Nikitarc/AASun/AASun_External_Loader/changelog.txt

For the last release of AdAstra-RTK visit AdAstra-Soft . com

AASun_External_Loader is an external loader for STM32CubeProgrammer
It is configured for development and debug.
Can be compiled as standard version (with G071xx.ld) for test and debug
or as external loader with extLoader.ld

The project is configured for a G071CB custom board

--------------------------------------------------------
23/01		Project external loader AASun_W25Q64 for AASun

23/05/24	V1.0

23/09/30	V1.1	Use HSI as clock source (was HSE)

--------------------------------------------------------
