Nikitarc/AASun/DipTrace/AASun_1.0/AASun_PCB_V1.0.pdf

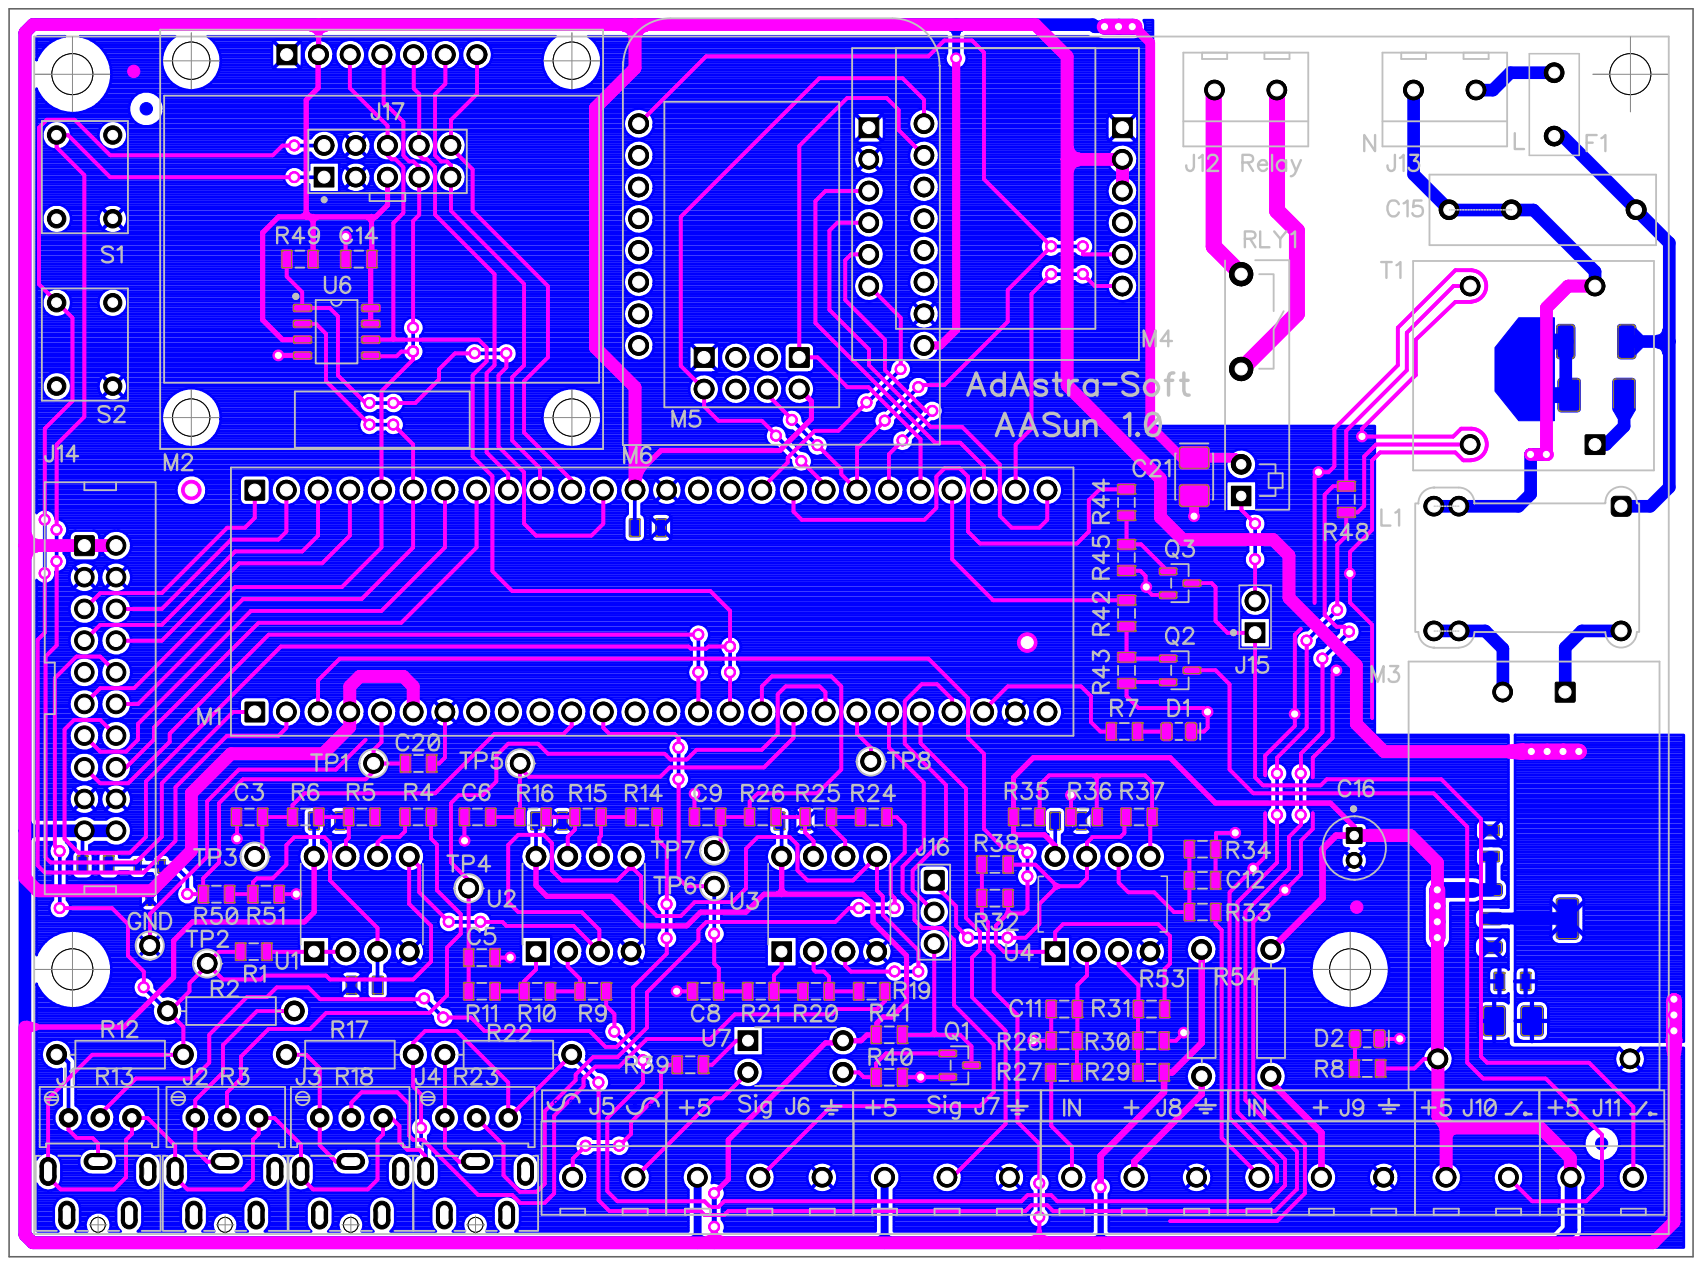
[picture p51: page 1]
