Nikitarc/AASun/DipTrace/AASun_1.0/AASun_Sch_V1.0.pdf

# R30 33k R31 220k R³² ⁴.7k R³³ ³.3k R³⁴ ¹⁰k

R530

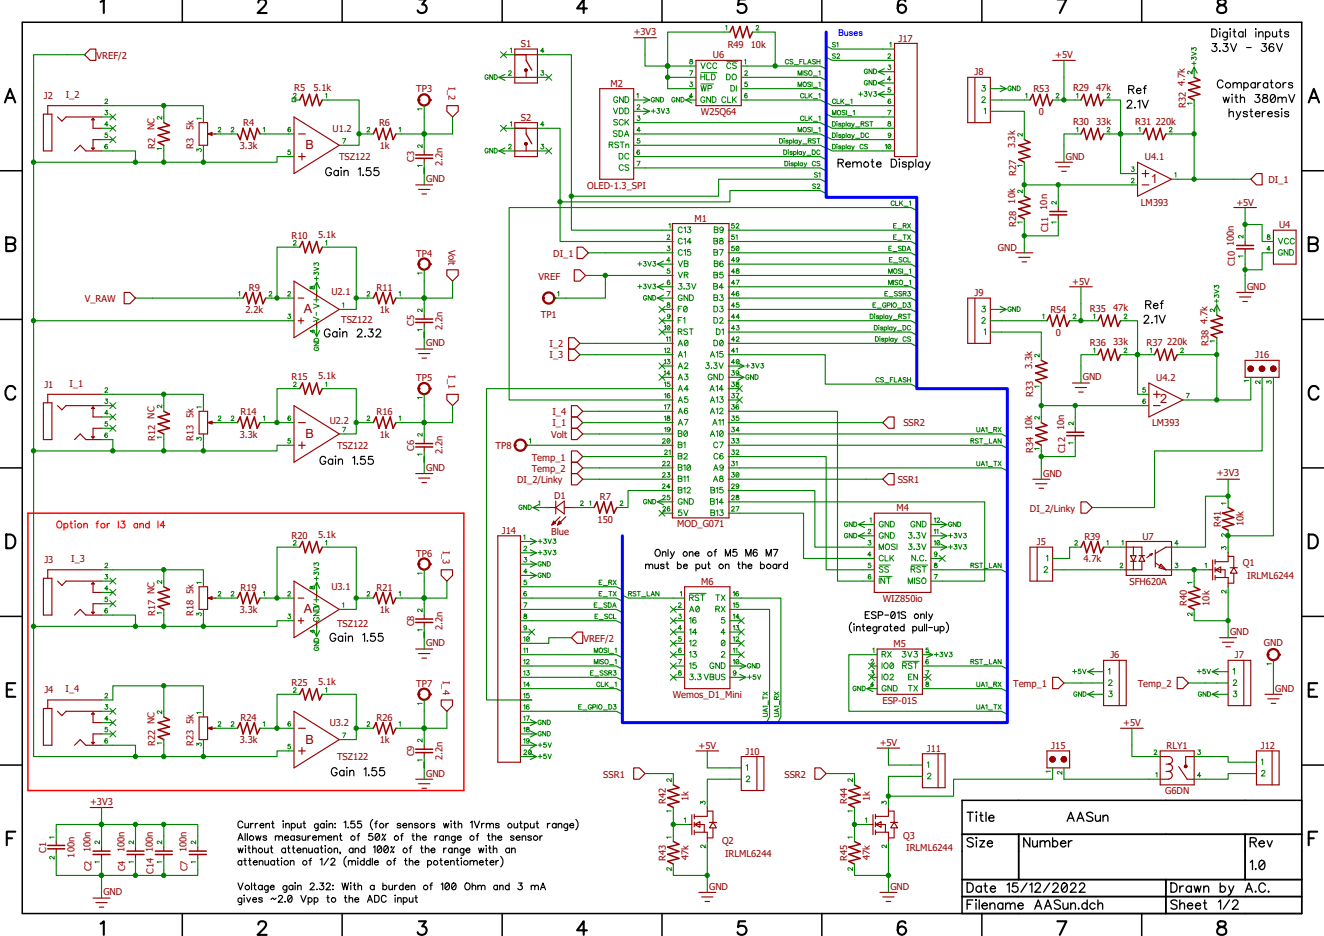
[picture p52: page 1]

A

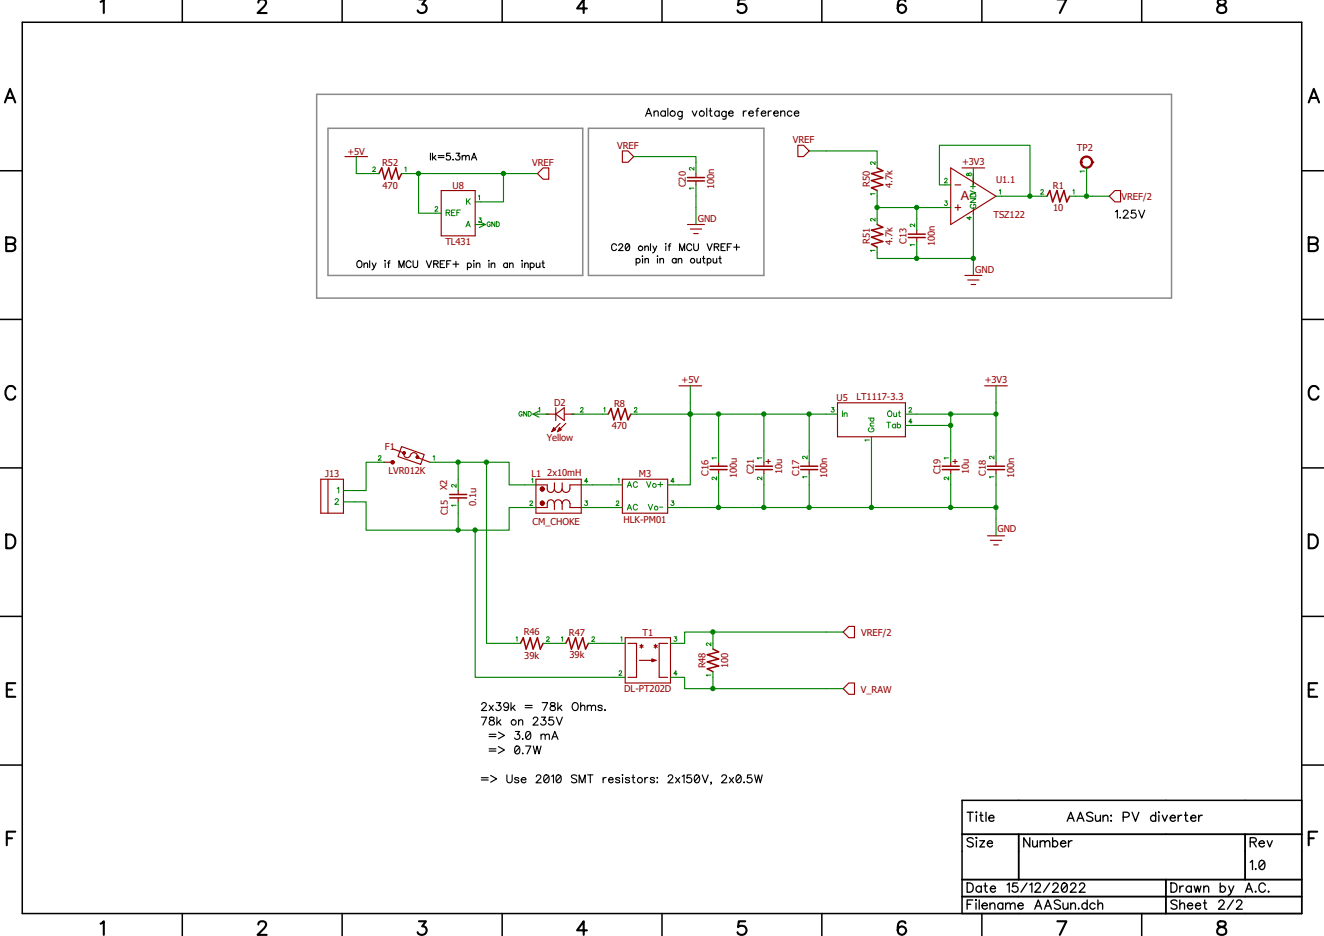
[picture p53: page 2]
