Nikitarc/AASun/DipTrace/AASun_Extension_1.1/AASun_Extension_PCB_V1.1.pdf

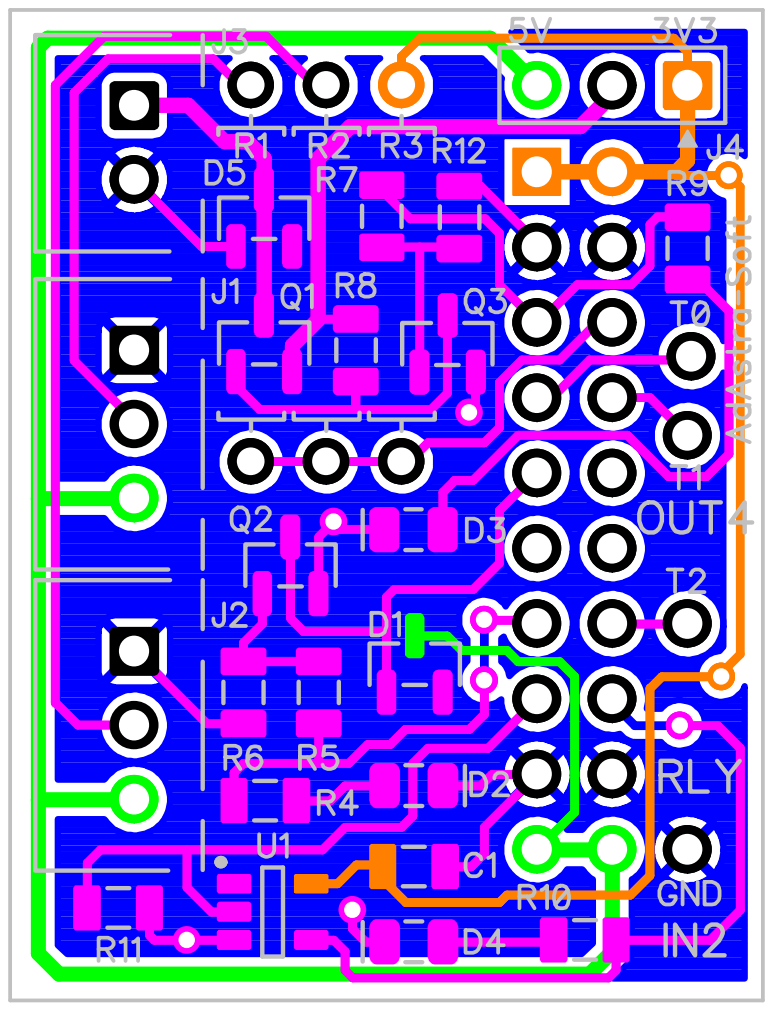
[picture p54: page 1]
