Nikitarc/AASun/DipTrace/AASun_Extension_1.1/AASun_Extension_Sch_V1.1.pdf

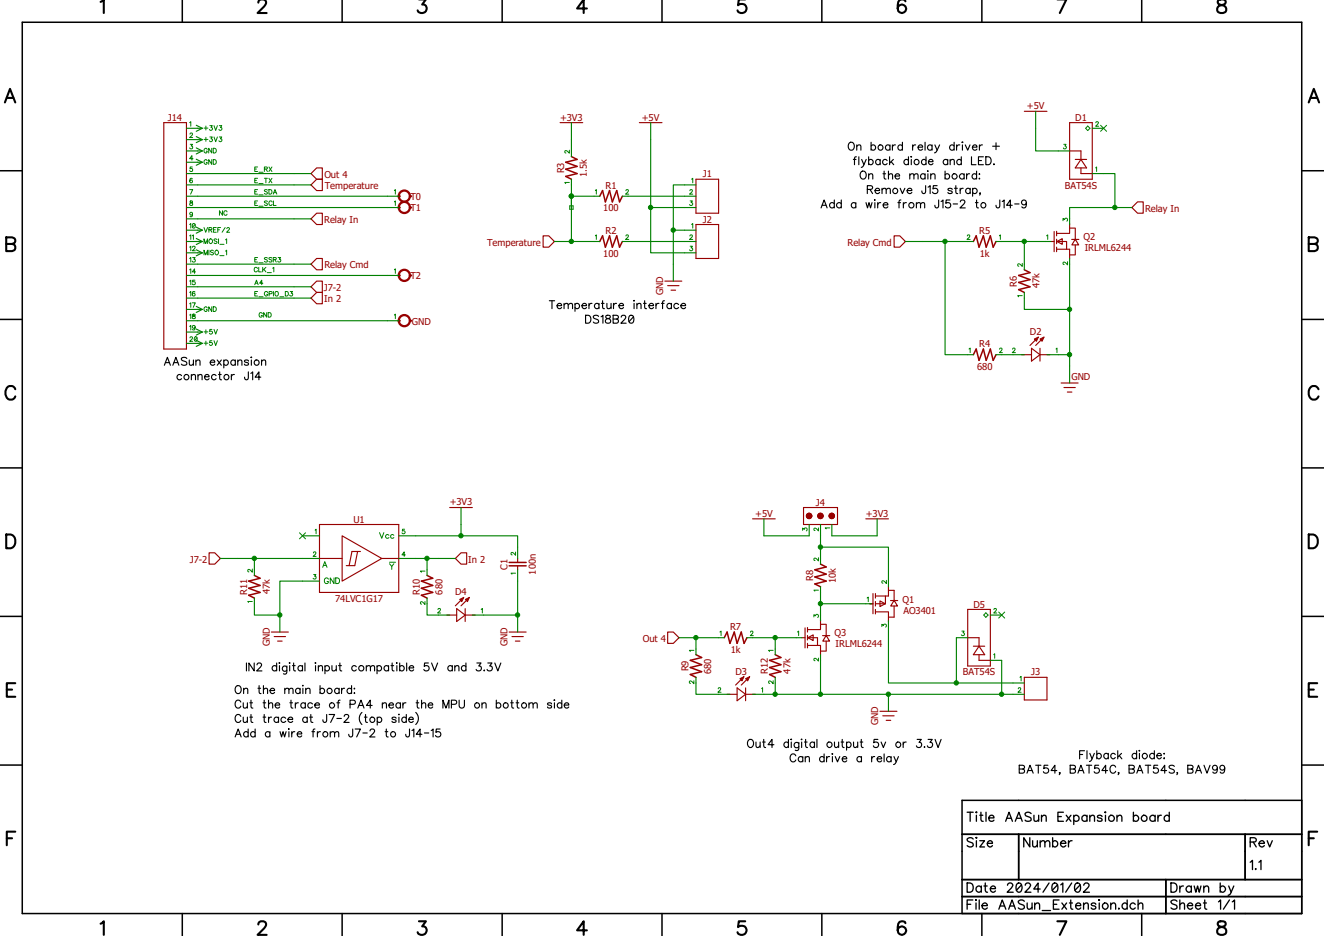
[picture p55: page 1]
