Nikitarc/AASun/(list of files, drawings)

Other design files:
DipTrace/AASun_1.0/AASun.dch
DipTrace/AASun_1.0/AASun.dip
DipTrace/AASun_1.0/AASunPanel.dip
DipTrace/AASun_Extension_1.1/AASun_Extension.dch
DipTrace/AASun_Extension_1.1/AASun_Extension.dip
