Nikitarc/AASun/AASun/AA/aakernel.c

/*
----------------------------------------------------------------------
	
	AdAstra - Real Time Kernel

	Alain Chebrou

	aakernel.c	Kernel base routines

	When		Who	What
	25/11/13	ac	Creation
	16/05/20	ac	V 1.8	Changed C++ static initialization
							Lightweight critical section added in aaTaskSwitch_()
	01/06/20	ac	V 1.9	Allow AA_MUTEX_MAX, AA_SEM_MAX, AA_TIMER_MAX, AA_QUEUE_MAX, AA_BUFPOOL_MAX to be 0
	12/06/21	ac	V 1.10	Remove simple mutex in aasema.c
							No more logMess task. The messages are displayed by the idle task.
	09/06/22	ac	V 1.11	TLSF: Fail to align to 0x04 or 0x0C in tlsfInit()
	17/04/24	ac	V 1.12	add aaIoResumeWaitingTask()

----------------------------------------------------------------------
*/
/*
----------------------------------------------------------------------
	Copyright (c) 2013-2023 Alain Chebrou - AdAstra-Soft . com
	All rights reserved.

	This file is part of the AdAstra Real Time Kernel distribution.

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
	- Redistributions of source code must retain the above copyright
	  notice, this list of conditions and the following disclaimer.

	- Redistributions in binary form must reproduce the above copyright
	  notice, this list of conditions and the following disclaimer in the
	  documentation and/or other materials provided with the distribution.

	- Neither the name of the copyright holder nor the
	  names of its contributors may be used to endorse or promote products
	  derived from this software without specific prior written permission.

	THIS SOFTWARE IS PROVIDED BY THE COPYRIGHT HOLDERS AND CONTRIBUTORS ``AS IS''
	AND ANY EXPRESS OR IMPLIED WARRANTIES, INCLUDING, BUT NOT LIMITED TO, THE IMPLIED
	WARRANTIES OF MERCHANTABILITY AND FITNESS FOR A PARTICULAR PURPOSE ARE
	DISCLAIMED. IN NO EVENT SHALL THE REGENTS AND CONTRIBUTORS BE LIABLE FOR ANY
	DIRECT, INDIRECT, INCIDENTAL, SPECIAL, EXEMPLARY, OR CONSEQUENTIAL DAMAGES
	(INCLUDING, BUT NOT LIMITED TO, PROCUREMENT OF SUBSTITUTE GOODS OR SERVICES;
	LOSS OF USE, DATA, OR PROFITS; OR BUSINESS INTERRUPTION) HOWEVER CAUSED AND
	ON ANY THEORY OF LIABILITY, WHETHER IN CONTRACT, STRICT LIABILITY, OR TORT
	(INCLUDING NEGLIGENCE OR OTHERWISE) ARISING IN ANY WAY OUT OF THE USE OF THIS
	SOFTWARE, EVEN IF ADVISED OF THE POSSIBILITY OF SUCH DAMAGE.
----------------------------------------------------------------------
*/

#define	AA_KERNEL_MAIN
#include	"aa.h"
#include	"aakernel.h"
#include	"aalogmes.h"
#include	"aatimer.h"

//--------------------------------------------------------------------------------
//	Return RTK version, with 2 numbers: Version - Release, eg 0x00010002 for 1.2

#define	AA_VERSION	((1u << 16u) | 11u)

uint32_t	aaVersion	(void)
{
	return AA_VERSION ;
}

//--------------------------------------------------------------------------------
// Task selector accelerator bitmap.
// In aaPrioGroup: 1 bit per priority level. Bit value is 1 when the corresponding ready list is not empty.
// Word 0 bit 0 is priority 0, word 1 bit 0 is priority bspPRIO_SIZE, etc.

#if (AA_PRIO_COUNT  > (BSP_PRIO_SIZE * BSP_PRIO_SIZE))
	#error AA_PRIO_COUNT should be lower than (BSP_PRIO_SIZE * BSP_PRIO_SIZE)
#endif

// Count of group words in aaPrioGroup. Can optimize code if value is 1 or 2
#define	aaPRIO_GROUP_COUNT	((AA_PRIO_COUNT+BSP_PRIO_SIZE-1) / BSP_PRIO_SIZE)

STATIC	bspPrio_t	aaPrioGroup [aaPRIO_GROUP_COUNT] ;

#if (aaPRIO_GROUP_COUNT > 2)
	// In aaPrioGroupIndex, a bit is 1 when the corresponding word in aaPrioGroup is not 0.
	STATIC	bspPrio_t	aaPrioGroupIndex ;
#endif

//--------------------------------------------------------------------------------

const char * const aaTaskStateName [aaMaxState] =
{
	"None", "Ready", "Delayed", "Suspended", "MutexWait", "SemWait", "SigWait", "QueueWait", "IoWait"
} ;

//--------------------------------------------------------------------------------
//	Return the highest priority with ready task
//	Priority 0 is the lowest

__STATIC_INLINE uint32_t	aaGetHighestPrio (void)
{
	#if (AA_PRIO_COUNT <= BSP_PRIO_SIZE)
	{
		// Only one word in accelerator bitmap
		AA_KERNEL_ASSERT (aaPrioGroup [0] != 0) ;		// Development check
		return bspMsbPos (aaPrioGroup [0]);
	}
	#elif (AA_PRIO_COUNT <= (2 * BSP_PRIO_SIZE))
	{
		// Only two words in accelerator bitmap
		if (aaPrioGroup [1] != 0)
		{
			// Some ready tasks are in the higher group
			return BSP_PRIO_SIZE + bspMsbPos (aaPrioGroup [1]) ;
		}
		else
		{
			// Ready tasks are only in lower group
			AA_KERNEL_ASSERT (aaPrioGroup [0] != 0) ;		// Development check
			return bspMsbPos (aaPrioGroup [0]) ;
		}
	}
	#else
	{
		// General slow case, with a aaPrioGroupIndex handling
		uint8_t	group, prio ;

		AA_KERNEL_ASSERT (aaPrioGroupIndex != 0) ;		// Development check

		group	= bspMsbPos (aaPrioGroupIndex) ;
		prio	= bspMsbPos (aaPrioGroup [group]) ;
		return prio	+ (group << 3) ;
	}
	#endif
}

//--------------------------------------------------------------------------------
//	Should be called from inside critical section
//	Remove a TCB from the priority accelerator tables, and from its ready list.
//	Whatever TCB position in the list.

void	aaRemoveReady_ (aaTcb_t * pTcb)
{
	uint8_t			prio = pTcb->priority ;
	aaListHead_t	* pList = & aaTaskReadyList [prio] ;

	AA_ERRORASSERT (pTcb != & aaTcbArray [0], AA_ERROR_KERNEL_1) ;		// The idle task !

	// Optimize code size and speed if aaPRIO_GROUP_COUNT is less than 2
	#if (aaPRIO_GROUP_COUNT == 1)
	{
		if (aaListCount1 (pList) == 1)
		{
			// There is only one task in this list, it will be empty
			// So clear the accelerator bit of this list
			aaPrioGroup [0]	&= ~(1u << prio) ;
		}
	}
	#endif

	#if (aaPRIO_GROUP_COUNT == 2)
	{
		if (aaListCount1 (pList) == 1)
		{
			// There is only one task in this list, so it will be empty
			// So clear the accelerator bit of this list
			if (prio < BSP_PRIO_SIZE)
			{
				aaPrioGroup [0]	&= ~(1 << prio) ;
			}
			else
			{
				aaPrioGroup [1]	&= ~(1 << (prio - BSP_PRIO_SIZE)) ;
			}
		}
	}
	#endif

	#if (aaPRIO_GROUP_COUNT > 2)
	{
		if (aaListCount1 (pList) == 1)
		{
			// This ready task list has only 1 task, remove its bit in accelerator table
			uint8_t	groupIndex ;

			groupIndex					 = prio >> BSP_PRIO_POW ;
			aaPrioGroup [groupIndex]	&= ~(1 << (prio & BSP_PRIO_MASK)) ;
			if (aaPrioGroup [groupIndex] == 0)
			{
				aaPrioGroupIndex &= ~(1 << groupIndex) ;
				AA_KERNEL_ASSERT (aaPrioGroupIndex != 0) ;		// Development check, there is never 0 task
			}
		}
	}
	#endif

	// Remove task from ready list
	aaListRemove (pList, & pTcb->listNode) ;
}

//--------------------------------------------------------------------------------
//	Add a TCB to the priority accelerator tables and to tail of its ready list.
//	Should be called from inside critical section

void	aaAddReady_ (aaTcb_t * pTcb)
{
	uint8_t	prio = pTcb->priority ;

	// Optimize code size and speed if aaPRIO_GROUP_COUNT is 1 or 2
	#if (aaPRIO_GROUP_COUNT == 1)
	{
		aaPrioGroup [0]	|= 1u << prio ;
	}
	#endif

	#if (aaPRIO_GROUP_COUNT == 2u)
	{
		if (prio < BSP_PRIO_SIZE)
		{
			aaPrioGroup [0]	|= 1u << prio ;
		}
		else
		{
			aaPrioGroup [1]	|= 1u << (prio - BSP_PRIO_SIZE) ;
		}
	}
	#endif

	#if (aaPRIO_GROUP_COUNT > 2u)
	{
		if (aaListIsEmpty (& aaTaskReadyList [prio]) == 1u)
		{
			// This is the first task added to this list, add bits to accelerator table
			uint8_t	groupIndex ;

			groupIndex					 = prio >> BSP_PRIO_POW ;
			aaPrioGroup [groupIndex]	|= 1u << (prio & BSP_PRIO_MASK) ;
			aaPrioGroupIndex			|= 1u << groupIndex ;
		}
	}
	#endif

	pTcb->state = aaReadyState ;		// Clear suspended flag
	aaListAddTail (& aaTaskReadyList [prio], & pTcb->listNode) ;
}

//--------------------------------------------------------------------------------
//	Put list node in list ordered by decreasing value of node value field.
//	For mutex/sem list value is a priority, so head of list is the highest priority TCB,
//	and tasks of equal priority are Last In First Out (LIFO)
//	Must be called from critical section

void	aaListAddOrdered_ (aaListHead_t * pList, aaListNode_t * pNodeAdd)
{
	aaListNode_t	* pNode ;

	pNode = (aaListNode_t *) pList ;
	while (aaListIsLast (pList, pNode) == 0)
	{
		pNode = aaListGetNext (pNode) ;
		if (pNode->value < pNodeAdd->value)
		{
			// Insert before this node
			aaListAddAfter (pList, aaListGetPrev (pNode), pNodeAdd) ;
			return ;
		}
	}
	// Add at end of list
	aaListAddAfter (pList, pNode, pNodeAdd) ;
}

//--------------------------------------------------------------------------------
//	This is the most used routine, so it is the most accelerated

void	aaSchedule_ ()
{
	aaCriticalEnter () ;

	// No scheduling if kernel not started or in interrupt service routine
	if ((aaIsRunning != 0)  &&  (aaIsInIsr () == 0))
	{
		pAaNextTcb = (aaTcb_t *) aaListGetFirst (& aaTaskReadyList [aaGetHighestPrio ()])->ptr.pOwner ;

		if (pAaNextTcb != pAaCurrentTcb)
		{
			// Switch tasks
			bspTaskSwitch () ;
#if defined AA_WIN32_PORT
			// WIN32 port: aaCriticalExit done by bspTaskSwitch
			return ;
#endif
		}
	}
	aaCriticalExit () ;
	// The switch is effectively done here
	// flush pipeline to ensure exception takes effect before we return from this routine
	__ASM ("isb") ;
}

//--------------------------------------------------------------------------------
//	To be called at end of every interrupt handler

void	aaIntExit			(void)
{
	aaIrqStatus_t	intState ;

	intState = bspSaveAndDisableIrq () ;

	AA_ERRORASSERT (aaIsInIsr () != 0, AA_ERROR_KERNEL_3) ;
	aaInIsrCounter -- ;
	if (aaInIsrCounter == 0)
	{
		pAaNextTcb = (aaTcb_t *) aaListGetFirst (& aaTaskReadyList [aaGetHighestPrio ()])->ptr.pOwner ;

		if (pAaNextTcb != pAaCurrentTcb)
		{
			bspTaskSwitchFromIsr () ;
		}
	}

	aaTraceInterruptExit () ;

	bspRestoreIrq (intState) ;
}

//--------------------------------------------------------------------------------
//	This function is called by the context switching ISR at bsp level
//	Only referenced by inline assembly, so need "used" attribute

void	__attribute__ ((section(".after_vectors"),used)) aaTaskSwitch_ (void)
{
	aaIrqStatus_t	intState ;

	// Check the stack overflow of the current task before swapping it
	if ((pAaCurrentTcb->flags & AA_FLAG_STACKCHECK) != 0)
	{
		bspStackType_t	* pStack ;

		#if (bspSTACK_GROWS_DOWN != 0)
		{
			// For CPU whose stack grows from high to low addresses
			pStack = pAaCurrentTcb->pStack ;
			if (pStack >= pAaCurrentTcb->pTopOfStack)
			{
				// Stack overflow. Notify only once
				if ((pAaCurrentTcb->flags |= AA_FLAG_STACKOVFL_) != 0)
				{
					aaUserNotify (AA_NOTIFY_STACKOVFL, pAaCurrentTcb->taskIndex | AA_HTAG_TASK) ;
					pAaCurrentTcb->flags |= AA_FLAG_STACKOVFL_ ;
				}
			}
			else
			{
				// Check stack threshold
				if (pStack [8] != bspSTACK_PATTERN  ||  pStack [7] != bspSTACK_PATTERN)
				{
					// Stack threshold reached. Notify only once
					if ((pAaCurrentTcb->flags |= AA_FLAG_STACKTHR_) != 0)
					{
						aaUserNotify (AA_NOTIFY_STACKTHR, pAaCurrentTcb->taskIndex | AA_HTAG_TASK) ;
						pAaCurrentTcb->flags |= AA_FLAG_STACKTHR_ ;
					}
				}
			}
		}
		#else
		{
			// For CPU whose stack grows from low to high addresses
			pStack = & pAaCurrentTcb->pStack [pAaCurrentTcb->stackSize-1];
			if (pStack <= pAaCurrentTcb->pTopOfStack)
			{
				// Stack overflow. Notify only once
				if ((pAaCurrentTcb->flags |= AA_FLAG_STACKOVFL_) != 0)
				{
					aaUserNotify (AA_NOTIFY_STACKOVFL, pAaCurrentTcb->taskId) ;
					pAaCurrentTcb->flags |= AA_FLAG_STACKOVFL_ ;
				}
			}
			else
			{
				// Check stack threshold
				if (pStack [-8] != bspSTACK_PATTERN  ||  pStack [-9] != bspSTACK_PATTERN)
				{
					// Stack threshold reached. Notify only once
					if ((pAaCurrentTcb->flags |= AA_FLAG_STACKTHR_) != 0)
					{
						aaUserNotify (AA_NOTIFY_STACKTHR, pAaCurrentTcb->taskId) ;
						pAaCurrentTcb->flags |= AA_FLAG_STACKTHR_ ;
					}
				}
			}
		}
		#endif
	}

	#if (AA_WITH_TASKSTAT == 1)
	{
		// Compute task running time
		uint32_t delta = bspTsDelta (& aaTsTaskSwitch) ;
		pAaCurrentTcb->cpuUsage += delta ;
		aaCpuUsage += delta ;
	}
	#endif

	// Now we will use pAaNextTcb.
	// It can be changed by a nested interrupt up to this point.
	// We don't want it to change while we use it => lightweight critical section
	intState = bspSaveAndDisableIrq () ;

#if (AA_WITH_NEWLIB_REENT == 1)
	// Set newlib impure ptr for the next task
	_impure_ptr = & pAaNextTcb->newlibReent ;
#endif

	aaTraceTaskSwitch (pAaCurrentTcb->taskIndex,  pAaNextTcb->taskIndex) ;

	pAaCurrentTcb = pAaNextTcb ;

	bspRestoreIrq (intState) ;
}

//--------------------------------------------------------------------------------
//--------------------------------------------------------------------------------
//	Tick and delay handling

//--------------------------------------------------------------------------------
//	Put a task in delayed list
//	Internal API
//	Must be called from critical section

void	aaAddToDelayedList_ (aaTcb_t * pTcb, uint32_t delay)
{
	aaListNode_t	* pNode ;

	AA_KERNEL_ASSERT (aaInCriticalCounter != 0) ;		// Development check
	if (delay == 0)
	{
		return ;
	}

	if (delay == AA_INFINITE)
	{
		// Special case for infinite delay: add at end of list
		pTcb->listNode.value = delay ;
		aaListAddTail (& aaTaskDelayedList, & pTcb->listNode) ;
	}
	else if (aaListIsEmpty (& aaTaskDelayedList) == 1)
	{
		// Empty list add
		pTcb->listNode.value = delay ;
		aaListAddTail (& aaTaskDelayedList, & pTcb->listNode) ;
	}
	else
	{
		// Add non infinite delay to non empty list
		pNode = (aaListNode_t *) & aaTaskDelayedList ;
		while (aaListIsLast (& aaTaskDelayedList, pNode) == 0)
		{
			if (delay <= aaListGetNext (pNode)->value)
			{
				break ;
			}
			delay -= aaListGetNext (pNode)->value ;
			pNode = aaListGetNext (pNode) ;
		}
		// Insert after pNode
		// If pNode is not the last node with finite delay value : adjust next node value
		if (aaListIsLast (& aaTaskDelayedList, pNode) == 0  &&  aaListGetNext (pNode)->value != AA_INFINITE)
		{
			aaListGetNext (pNode)->value -= delay ;
		}
		pTcb->listNode.value = delay ;
		aaListAddAfter (& aaTaskDelayedList, pNode, & pTcb->listNode) ;
	}
}

//--------------------------------------------------------------------------------
//	Remove one node from delayed task list, adjust next task delay
//	Internal API
//	Should be called within critical section

void	aaRemoveFromDelayedList_ (aaListNode_t * pNode)
{
	AA_KERNEL_ASSERT (aaInCriticalCounter != 0) ;	// Development check

	if (aaListIsLast (& aaTaskDelayedList, pNode) == 0  &&  aaListGetNext (pNode)->value != AA_INFINITE)
	{
		aaListGetNext (pNode)->value += pNode->value ;
	}
	aaListRemove (& aaTaskDelayedList, pNode) ;
}

//--------------------------------------------------------------------------------
//	Tick handling, called by tick interrupt.
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
