Nikitarc/AASun/(commit log)

2024-02-12 Initial release
    [AASun.dch, AASun.dip, AASunPanel.dip, AASun_BOM_V1.0.csv, AASun_Extension.dch, AASun_Extension.dip, AASun_Extension_BOM_V1.1.csv]
2024-02-18 Ajout # pour comparaison variable dans les regles de forçage
2024-05-12 Add WIFI
    [partitions.csv]
